mlarroque/TC-TPFF/Informe/Imagenes/etapa5.png

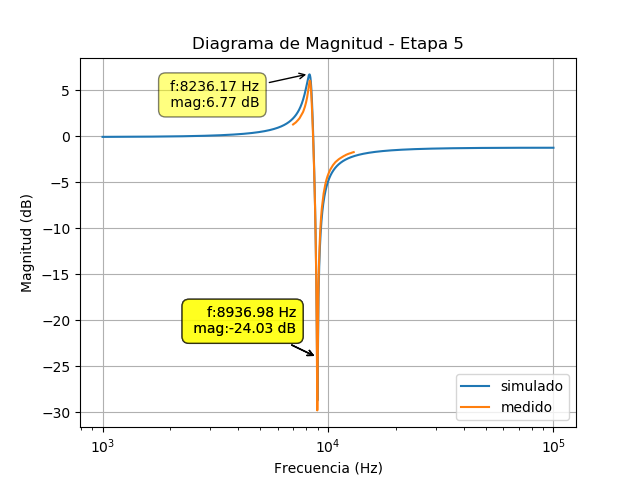
Informe/Imagenes/etapa5.png
