mlarroque/TC-TPFF/Informe/Imagenes/etapa6.png

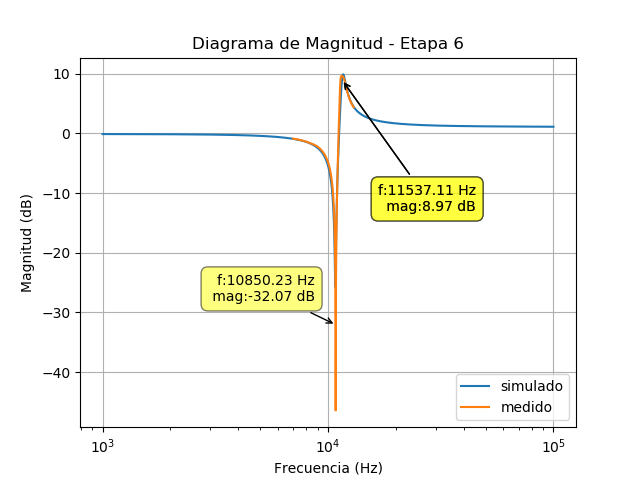
Informe/Imagenes/etapa6.png
