mlarroque/TC-TPFF/Informe/Imagenes/etapasJuntas.png

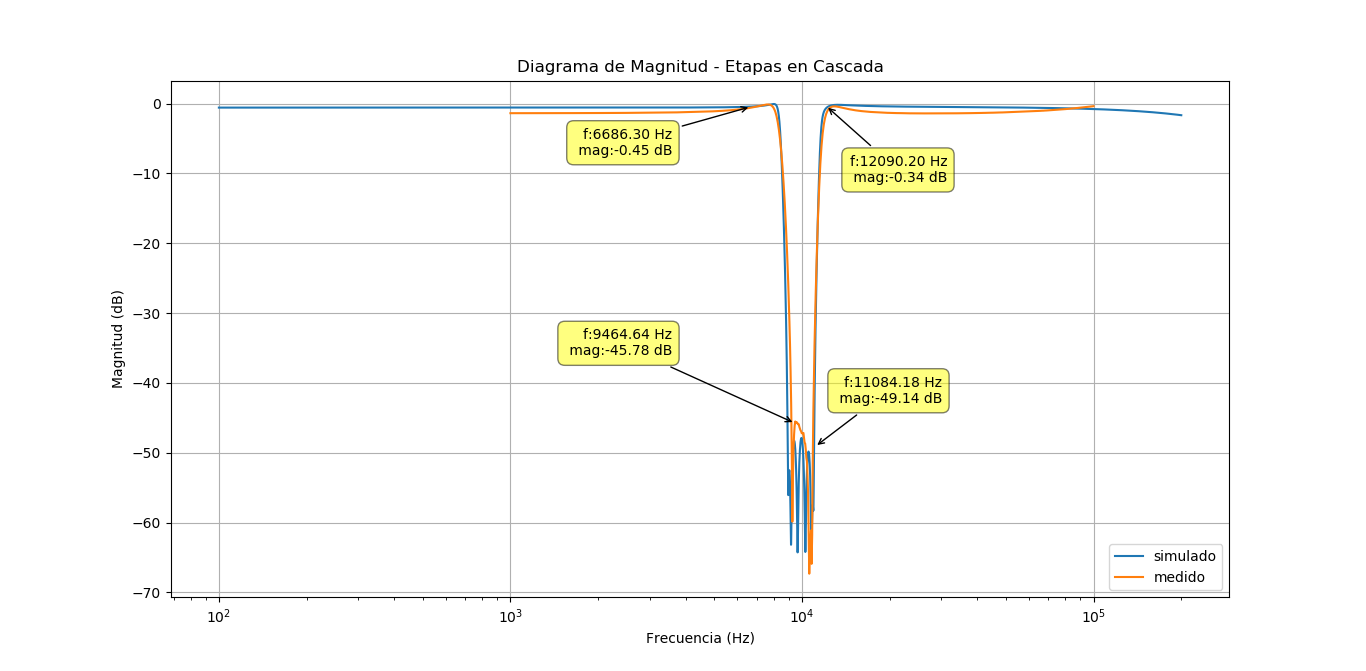
Informe/Imagenes/etapasJuntas.png
