mlarroque/TC-TPFF/Informe/Imagenes/fotoFILTRO.PNG

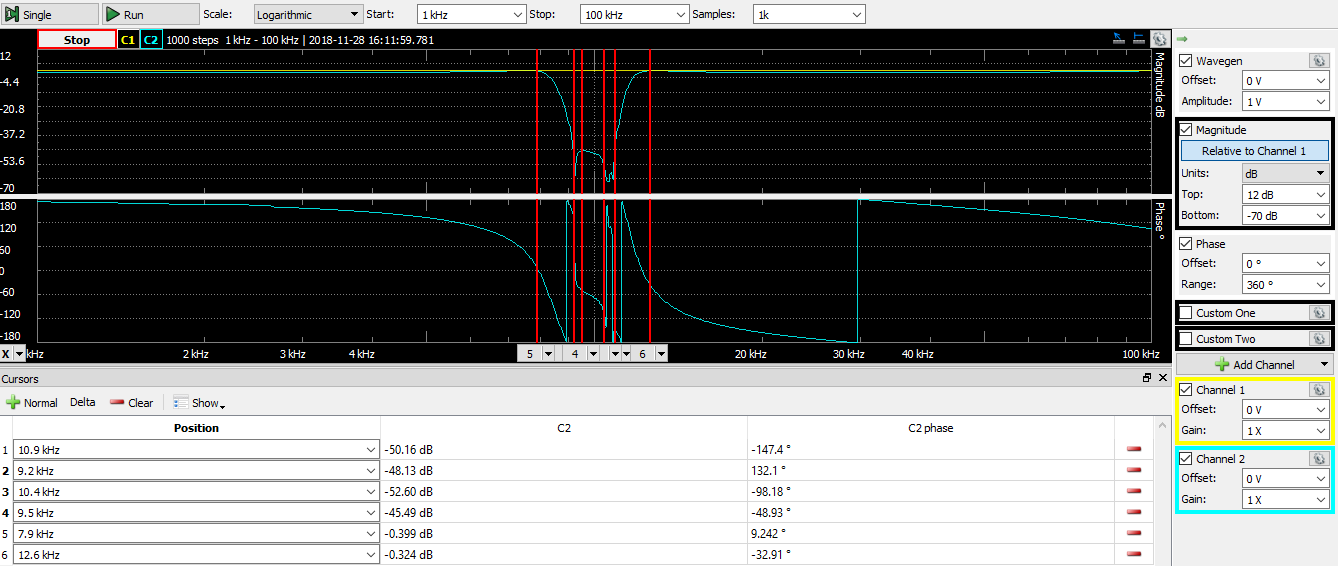
Informe/Imagenes/fotoFILTRO.PNG
