mlarroque/TC-TPFF/Informe/Imagenes/rtaESCALON.PNG

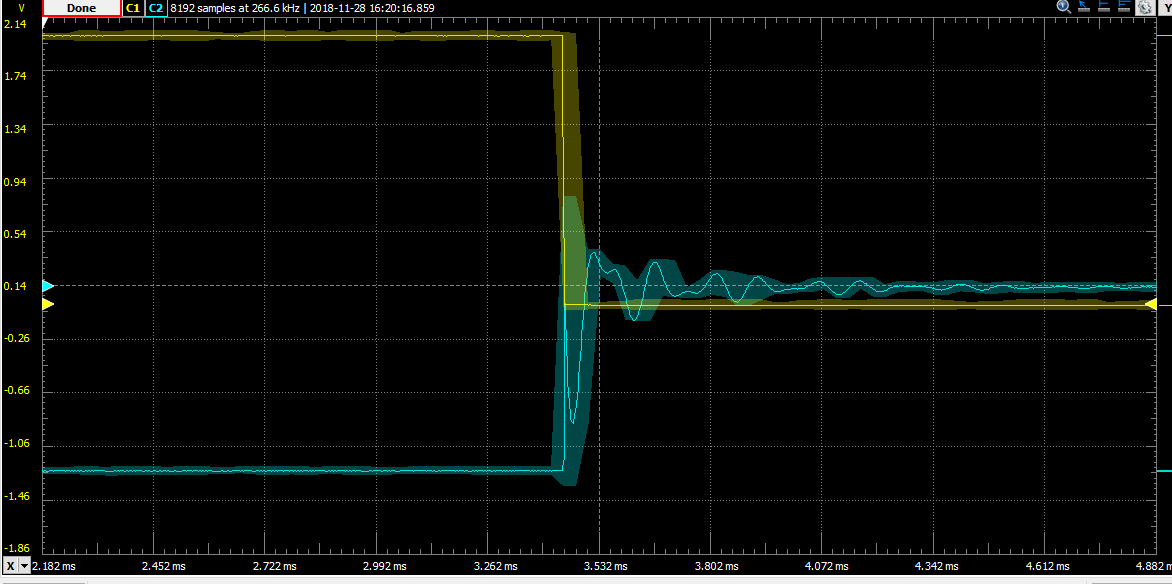
Informe/Imagenes/rtaESCALON.PNG
