mlarroque/TC-TPFF/Informe/Imagenes/SimTransfTotal.PNG

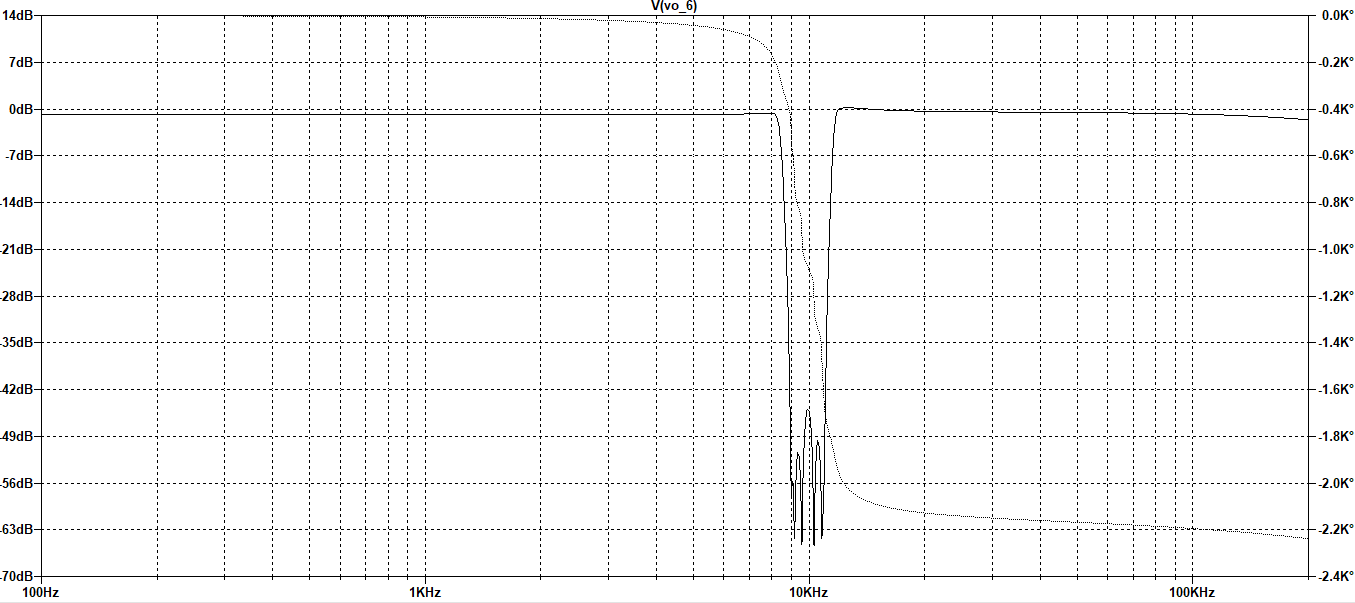
Informe/Imagenes/SimTransfTotal.PNG
