mlarroque/TC-TPFF/matlab_pablo/pablo_etapa1.PNG

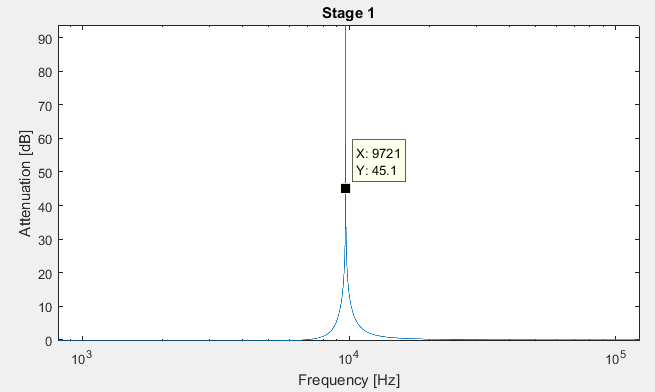
matlab_pablo/pablo_etapa1.PNG
