mlarroque/TC-TPFF/matlab_pablo/pablo_etapa2.PNG

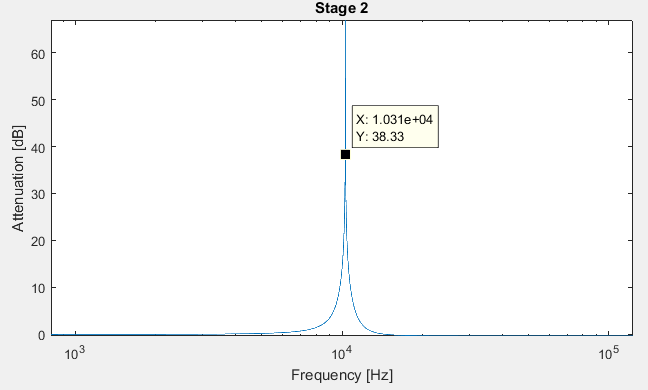
matlab_pablo/pablo_etapa2.PNG
