mlarroque/TC-TPFF/matlab_pablo/pablo_etapa3.PNG

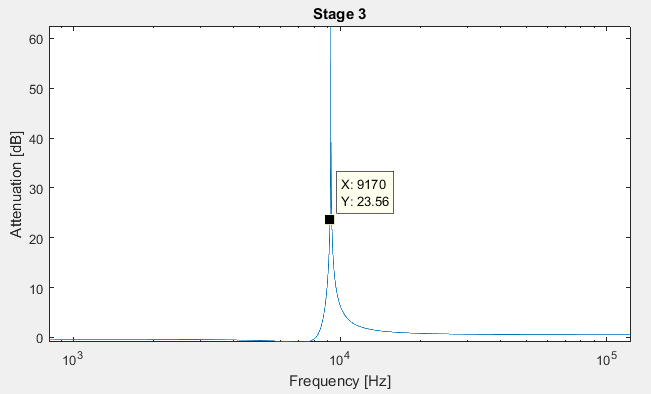
matlab_pablo/pablo_etapa3.PNG
