mlarroque/TC-TPFF/matlab_pablo/pablo_etapa5.PNG

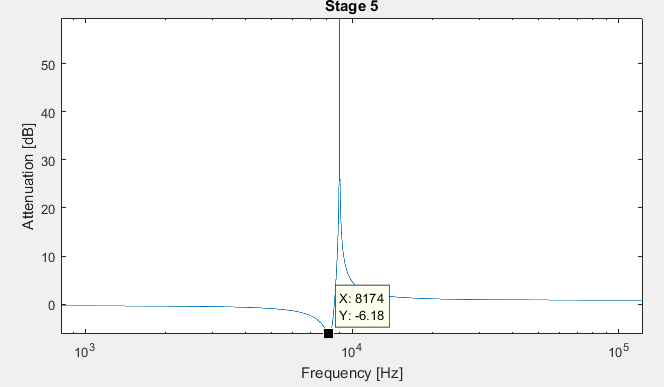
matlab_pablo/pablo_etapa5.PNG
