mlarroque/TC-TPFF/matlab_pablo/pablo_etapasJuntas.PNG

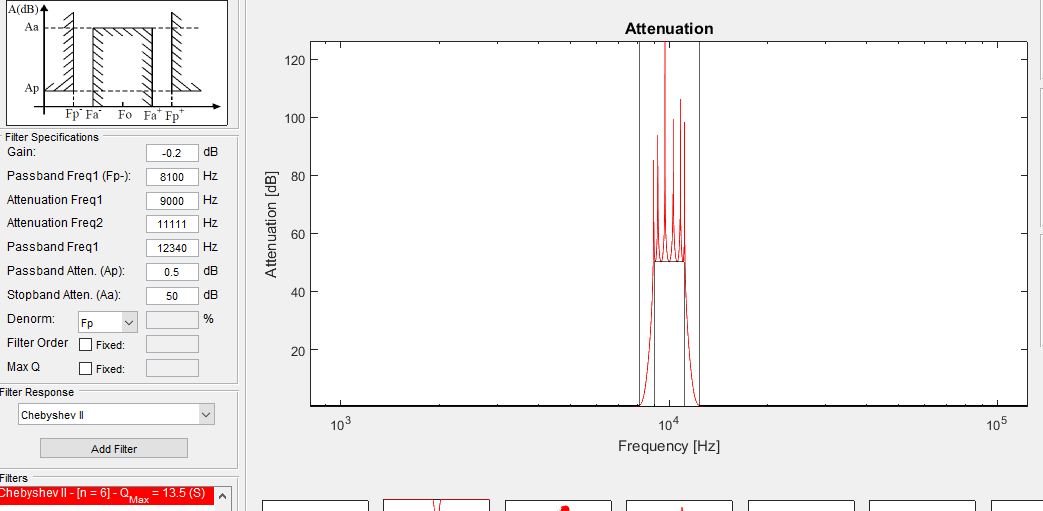
matlab_pablo/pablo_etapasJuntas.PNG
