mlarroque/TC-TPFF/matlab_pablo/publish/Filter_ImpulseResponse.png

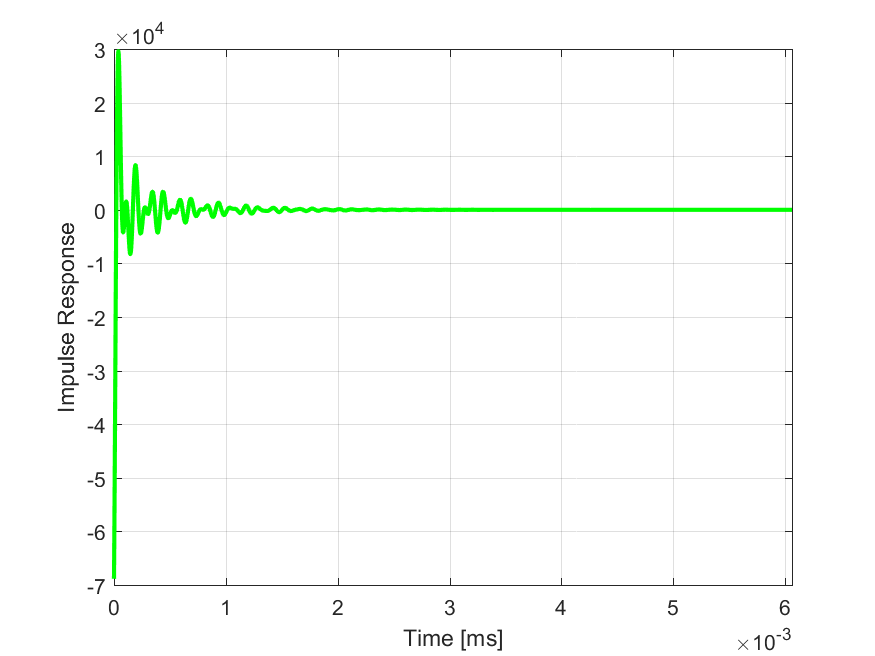
matlab_pablo/publish/Filter_ImpulseResponse.png
