mlarroque/TC-TPFF/matlab_pablo/publish/Plantillas/BandpassImg2.png

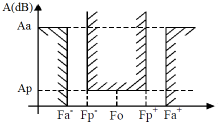
matlab_pablo/publish/Plantillas/BandpassImg2.png
