mlarroque/TC-TPFF/matlab_pablo/publish/Plantillas/HighpassImg2.png

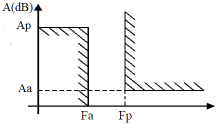
matlab_pablo/publish/Plantillas/HighpassImg2.png
