mlarroque/TC-TPFF/matlab_pablo/publish/Plantillas/LowpassImg2.png

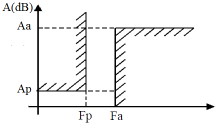
matlab_pablo/publish/Plantillas/LowpassImg2.png
