mlarroque/TC-TPFF/matlab_pablo/publish/Plantillas/StopbandImg2.png

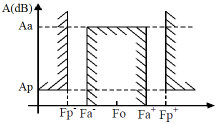
matlab_pablo/publish/Plantillas/StopbandImg2.png
