mlarroque/TC-TPFF/matlab_pablo/publish/Stages Schematics/Diff_Inv.png

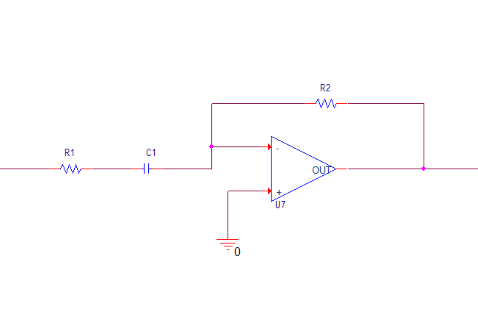
matlab_pablo/publish/Stages Schematics/Diff_Inv.png
