mlarroque/TC-TPFF/matlab_pablo/publish/Stages Schematics/Diff_No_Inv.png

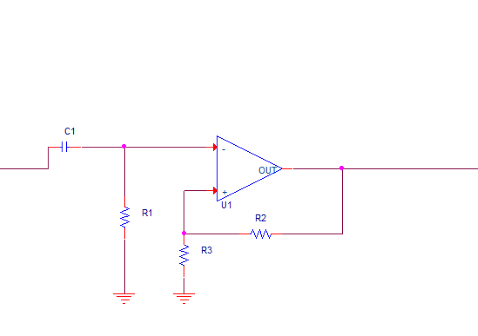
matlab_pablo/publish/Stages Schematics/Diff_No_Inv.png
