mlarroque/TC-TPFF/matlab_pablo/publish/Stages Schematics/Int_Inv.png

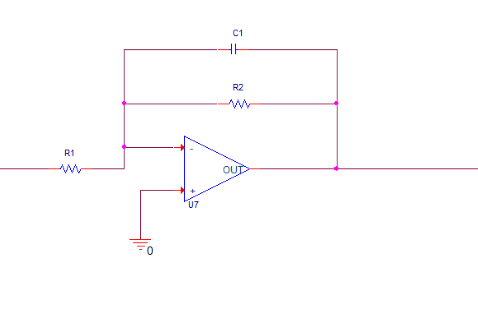
matlab_pablo/publish/Stages Schematics/Int_Inv.png
