mlarroque/TC-TPFF/matlab_pablo/publish/Stages Schematics/KHN_BP.PNG

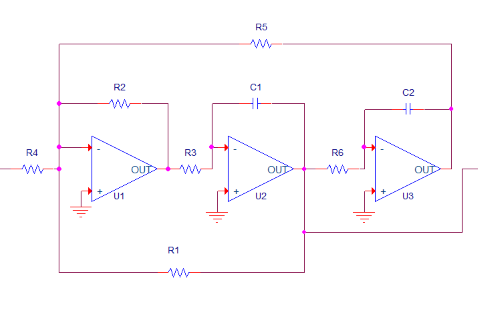
matlab_pablo/publish/Stages Schematics/KHN_BP.PNG
