mlarroque/TC-TPFF/matlab_pablo/publish/Stages Schematics/KHN_BS.PNG

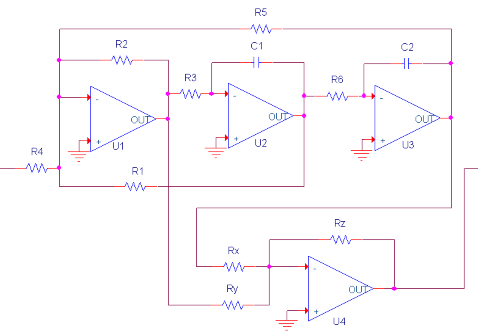
matlab_pablo/publish/Stages Schematics/KHN_BS.PNG
