mlarroque/TC-TPFF/matlab_pablo/publish/Stages Schematics/Sedra_HPNotch.png

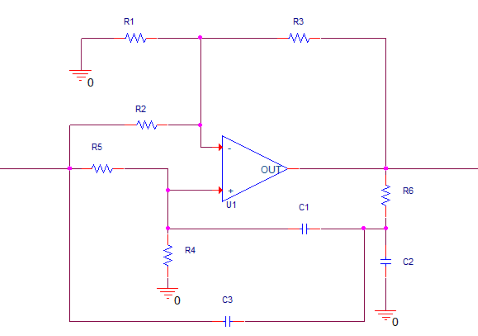
matlab_pablo/publish/Stages Schematics/Sedra_HPNotch.png
