mlarroque/TC-TPFF/matlab_pablo/publish/Stages Schematics/SK_HP.PNG

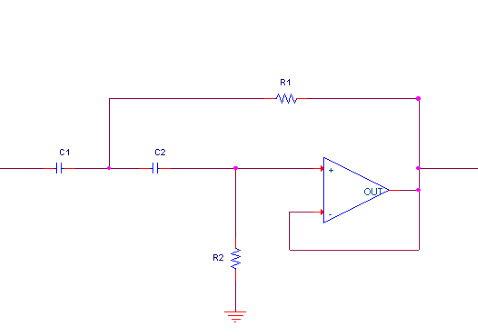
matlab_pablo/publish/Stages Schematics/SK_HP.PNG
