mlarroque/TC-TPFF/matlab_pablo/publish/Stages Schematics/SK_HP_G.PNG

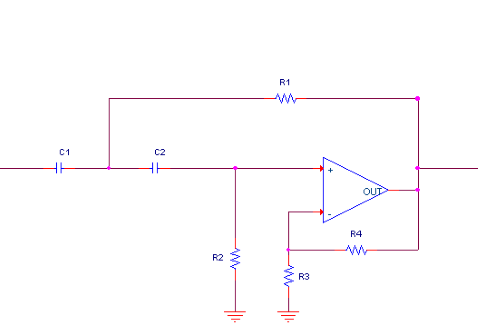
matlab_pablo/publish/Stages Schematics/SK_HP_G.PNG
