mlarroque/TC-TPFF/matlab_pablo/publish/Stages Schematics/SK_LP_A.PNG

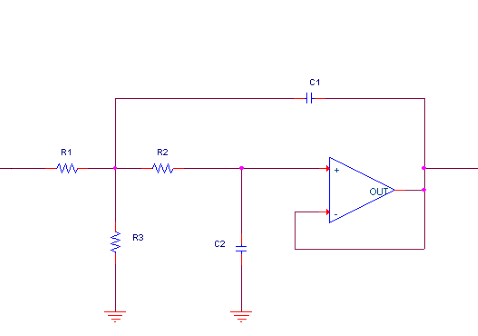
matlab_pablo/publish/Stages Schematics/SK_LP_A.PNG
