mlarroque/TC-TPFF/matlab_pablo/publish/Stages Schematics/TF.PNG

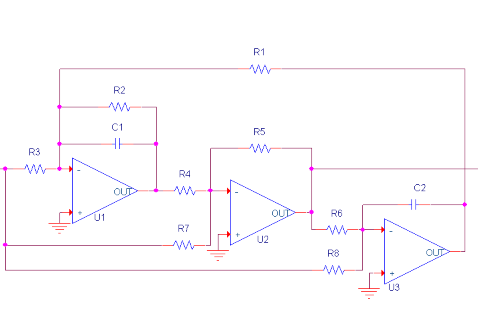
matlab_pablo/publish/Stages Schematics/TF.PNG
