mlarroque/TC-TPFF/simulaciones/montecarlo_versionFinal.PNG

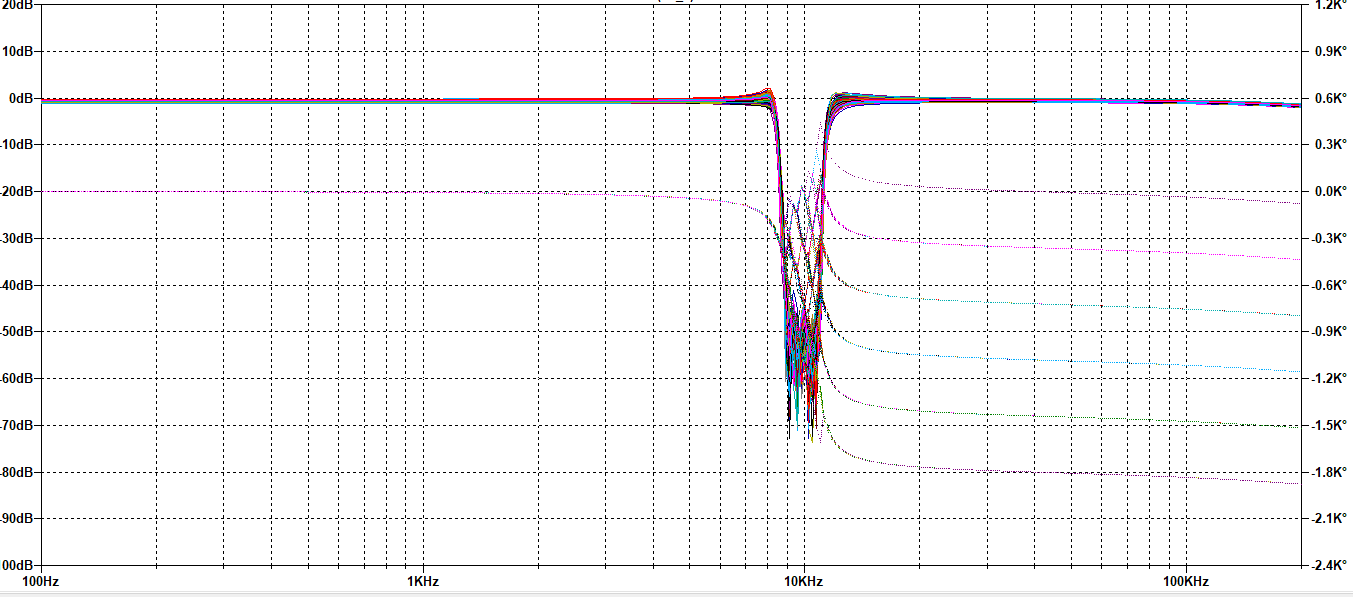
simulaciones/montecarlo_versionFinal.PNG
