mlarroque/TC-TPFF/simulaciones/montecarlo_versionFinal_algunosMatches.PNG

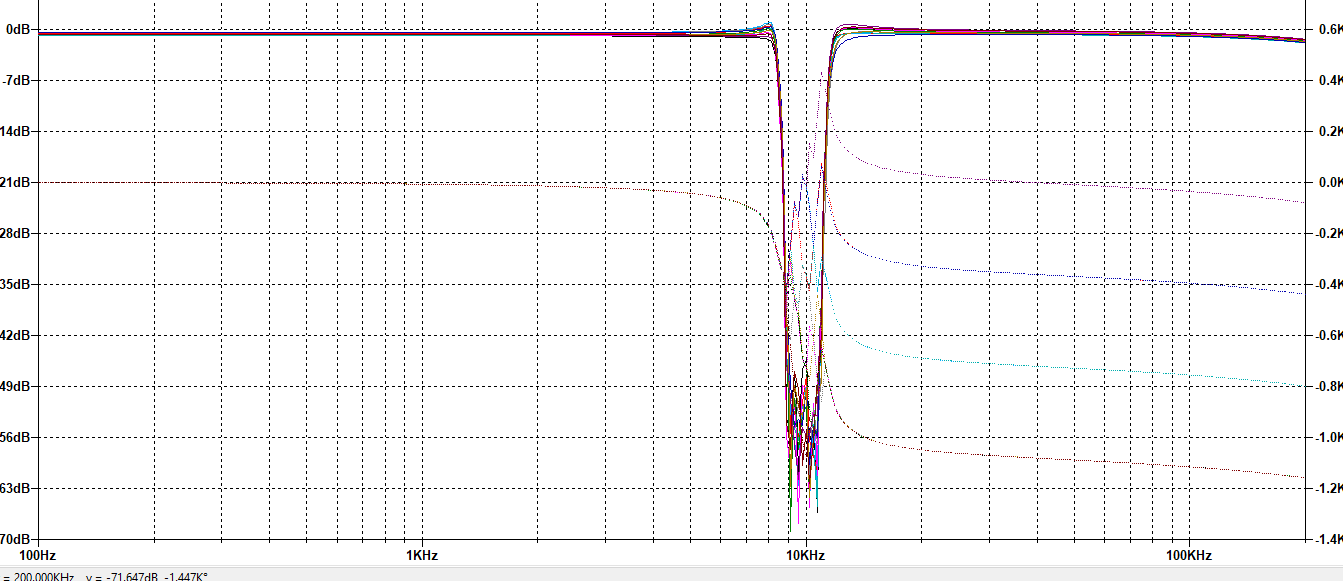
simulaciones/montecarlo_versionFinal_algunosMatches.PNG
