mlarroque/TC-TPFF/simulaciones/sim_etapasJuntasMonteCarloConMATCHES.asc

C1_1: cap; 1n
C1_2: cap; {mc(1n,tol}
C1_3: cap; 1n
C1_4: cap; 1n
C1_5: cap; 1n
C1_6: cap; 1n
C2_1: cap; 1n
C2_2: cap; {mc(1n,tol}
C2_3: cap; 1n
C2_4: cap; 1n
C2_5: cap; 1n
C2_6: cap; 1n
R1_1: res; 4500
R1_2: res; 4417
R1_3: res; 3150
R1_4: res; 3332
R1_5: res; 1227
R1_6: res; 1100
R2_1: res; 59600
R2_2: res; 54190
R2_3: res; 66k
R2_4: res; 89k
R2_5: res; 247k
R2_6: res; 190k
R3_1: res; 180k
R3_2: res; 180k
R3_3: res; 180k
R3_4: res; 180k
R3_5: res; 180k
R3_6: res; 180k
R4_1: res; 59600
R4_2: res; 54190
R4_3: res; 66k
R4_4: res; 89k
R4_5: res; 247k
R4_6: res; 190k
R5_1: res; 171k
R5_2: res; 185k
R5_3: res; 197k
R5_4: res; 161k
R5_5: res; 156k
R5_6: res; 205k
R6_1: res; 178k
R6_2: res; 178k
R6_3: res; 178k
R6_4: res; 178k
R6_5: res; 178k
R6_6: res; 178k
R7_1: res; 180k
R7_2: res; 180k
R7_3: res; 180k
R7_4: res; 180k
R7_5: res; 180k
R7_6: res; 180k
R8_1: res; 180k
R8_2: res; 180k
R8_3: res; 180k
R8_4: res; 180k
R8_5: res; 180k
R8_6: res; 180k
U1: opamp2; TL084
U2: opamp2; TL084
U3: opamp2; TL084
U4: opamp2; TL084
U5: opamp2; TL084
U6: opamp2; TL084
U7: opamp2; TL084
U8: opamp2; TL084
U9: opamp2; TL084
U10: opamp2; TL084
U11: opamp2; TL084
U12: opamp2; TL084
U13: opamp2; TL084
U14: opamp2; TL084
U15: opamp2; TL084
U16: opamp2; TL084
U17: opamp2; TL084
U18: opamp2; TL084
V1: voltage; SINE(0 1 1k 0 0 0 1000); AC 1
V2: voltage; 15
V3: voltage; 15
Named nets: +vcc, -vcc, 0, vo_1, vo_2, vo_3, vo_4, vo_5, vo_6
.inc TL084.MOD
.ac dec 2000 100 200k
.param tol=0.01
;step param run 1 10 5
;tran 10m startup
