mlarroque/TC-TPFF/simulaciones/sim_etapa4.asc

C1: cap; 1n
C2: cap; 1n
R1: res; 3.32k
R2: res; 89k
R3: res; 180k
R4: res; 89k
R5: res; 161k
R6: res; 178k
R7: res; 180k
R8: res; 180k
U1: opamp2; TL084
U2: opamp2; TL084
U3: opamp2; TL084
V1: voltage; 15
V2: voltage; 15
V3: voltage; ac 1
Named nets: 0, +vcc, -vcc, vo
.inc TL084.MOD
.ac dec 1000 1k 100k
