mlarroque/TC-TPFF/simulaciones/sim_etapasJuntasMonteCarlo.asc

C1_1: cap; {mc(1n,tol}
C1_2: cap; {mc(1n,tol}
C1_3: cap; {mc(1n,tol)}
C1_4: cap; {mc(1n,tol)}
C1_5: cap; {mc(1n,tol)}
C1_6: cap; {mc(1n,tol)}
C2_1: cap; {mc(1n,tol)}
C2_2: cap; {mc(1n,tol}
C2_3: cap; {mc(1n,tol)}
C2_4: cap; {mc(1n,tol)}
C2_5: cap; {mc(1n,tol)}
C2_6: cap; {mc(1n,tol)}
R1_1: res; {mc(4500,tol)}
R1_2: res; {mc(4417,tol)}
R1_3: res; {mc(3150,tol)}
R1_4: res; {mc(3332,tol)}
R1_5: res; {mc(1227,tol)}
R1_6: res; {mc(1100,tol)}
R2_1: res; {mc(59600,tol)}
R2_2: res; {mc(54190,tol)}
R2_3: res; {mc(66k,tol)}
R2_4: res; {mc(89k,tol)}
R2_5: res; {mc(247k,tol)}
R2_6: res; {mc(190k,tol)}
R3_1: res; {mc(180k,tol)}
R3_2: res; {mc(180k,tol)}
R3_3: res; {mc(180k,tol)}
R3_4: res; {mc(180k,tol)}
R3_5: res; {mc(180k,tol)}
R3_6: res; {mc(180k,tol)}
R4_1: res; {mc(59600,tol)}
R4_2: res; {mc(54190,tol)}
R4_3: res; {mc(66k,tol)}
R4_4: res; {mc(89k,tol)}
R4_5: res; {mc(247k,tol)}
R4_6: res; {mc(190k,tol)}
R5_1: res; {mc(171.5k,tol)}
R5_2: res; {mc(185k,tol}
R5_3: res; {mc(197k,tol)}
R5_4: res; {mc(161k,tol)}
R5_5: res; {mc(156k,tol)}
R5_6: res; {mc(205k,tol)}
R6_1: res; {mc(178k,tol)}
R6_2: res; {mc(178k,tol)}
R6_3: res; {mc(178k,tol)}
R6_4: res; {mc(178k,tol)}
R6_5: res; {mc(178.2k,tol)}
R6_6: res; {mc(178.2k,tol)}
R7_1: res; {mc(180k,tol)}
R7_2: res; {mc(180k,tol)}
R7_3: res; {mc(180k,tol)}
R7_4: res; {mc(180k,tol)}
R7_5: res; {mc(180k,tol)}
R7_6: res; {mc(180k,tol)}
R8_1: res; {mc(180k,tol)}
R8_2: res; {mc(180k,tol)}
R8_3: res; {mc(180k,tol)}
R8_4: res; {mc(180k,tol)}
R8_5: res; {mc(180k,tol)}
R8_6: res; {mc(180k,tol)}
U1: opamp2; TL084
U2: opamp2; TL084
U3: opamp2; TL084
U4: opamp2; TL084
U5: opamp2; TL084
U6: opamp2; TL084
U7: opamp2; TL084
U8: opamp2; TL084
U9: opamp2; TL084
U10: opamp2; TL084
U11: opamp2; TL084
U12: opamp2; TL084
U13: opamp2; TL084
U14: opamp2; TL084
U15: opamp2; TL084
U16: opamp2; TL084
U17: opamp2; TL084
U18: opamp2; TL084
V1: voltage; ac 1
V2: voltage; 15
V3: voltage; 15
Named nets: +vcc, -vcc, 0, vo_1, vo_2, vo_3, vo_4, vo_5, vo_6
.inc TL084.MOD
.ac dec 100 100 5Meg
.param tol=0.01
.step param run 1 10 5
