mlarroque/TC-TPFF/simulaciones/sim_etapa1_INTENTO2.asc

C1: cap; 10n
C2: cap; 10n
R1: res; 450
R2: res; 5962
R3: res; 200k
R4: res; 5962
R5: res; 448
R6: res; 465
R7: res; 200k
R8: res; 470
U1: opamp2; TL084
U2: opamp2; TL084
U3: opamp2; TL084
V1: voltage; 15
V2: voltage; 15
V3: voltage; ac 1
Named nets: 0, +vcc, -vcc, vo
.inc TL084.MOD
.ac dec 500 100 5Meg
