mlarroque/TC-TPFF/simulaciones/Estabilidad/sim_etapa3.asc

C1: cap; 1n
C2: cap; 1n
R1: res; 3148
R2: res; 69k
R3: res; 180k
R4: res; 69k
R5: res; 197.2k
R6: res; 178.2k
R7: res; 180k
R8: res; 180k
U1: opamp2; TL084
U2: opamp2; TL084
U3: opamp2; TL084
V1: voltage; 15
V2: voltage; 15
V3: voltage; ""; AC 1 0
Named nets: 0, +vcc, -vcc, vo, feedb, inv
.inc TL084.MOD
.ac dec 2000 100m 1Meg
