mlarroque/TC-TPFF/(list of files, drawings)

Other design files:
altium/archivosUsadosParaRuteo/altium_final.PrjPcb
altium/archivosUsadosParaRuteo/filtroFinal.PcbDoc
altium/etapa1.SchDoc
altium/etapa2.SchDoc
altium/etapa3.SchDoc
altium/etapa4.SchDoc
altium/etapa5.SchDoc
altium/etapa6.SchDoc
altium/filtroFinal-TC.SchDoc
altium/filtroFinal.PrjPCB
