mlarroque/TC-TPFF/(commit log)

2018-11-19 avances con los calculos de componentes y simulacion
2018-11-19 subo el informe del tp5 tomado de referencia
2018-11-24 se sube publish de pablo, y montecarlos en spice
2018-11-25 actualize el "paper"
2018-11-25 Hice una parte para simulaciones de estabilidad
2018-11-25 Hice las simulaciones de estabilidad
    [sim_etapa1.csv]
2018-11-25 Empezando los graficos de estabilidad
    [sim_etapa1.csv, sim_etapa1.xls, sim_etapa2.csv, sim_etapa3.csv, sim_etapa4.csv, sim_etapa5.csv, sim_etapa6.csv]
2018-11-25 se guardaron simulaciones de plantilla
    [etapa1.SchDoc, etapa2.SchDoc, etapa5.SchDoc]
2018-11-25 se termina la placa
    [etapa1.SchDoc, etapa2.SchDoc, etapa3.SchDoc, etapa4.SchDoc, etapa5.SchDoc, etapa6.SchDoc, filtroFinal-TC.SchDoc]
2018-11-25 Simule estabilidad
    [sim_etapa1.xls, sim_etapa2.csv, sim_etapa3.csv, sim_etapa4.csv, sim_etapa5.csv, sim_etapa6.csv]
2018-11-26 subo el ruteo de la placa
    [altium_final.PrjPcb, filtroFinal.PcbDoc]
2018-11-28 Progreso en el informe
    [bodeFinalCasiCasi.csv, bodeFinalLargo.csv, bodeFinalPOSTAPOSTA.csv, bodeFinalcorto.csv, etapa1.SchDoc, filtroFinal-TC.SchDoc, rtaESCA.csv]
2018-11-28 csv etapas
    [etapa1.csv, etapa2.csv, etapa3.csv, etapa4.csv, etapa5.csv, etapa6.csv]
2018-11-28 avance con los graficos
    [med_total.csv, sim_etapa1.csv, sim_etapa2.csv, sim_etapa3.csv, sim_etapa4.csv, sim_etapa5.csv, sim_etapa6.csv, sim_total.csv]
2018-11-28 se agregan imagenes
    [med_etapa1.csv, med_etapa2.csv, med_etapa3.csv, med_etapa4.csv, med_etapa5.csv, med_etapa6.csv, sim_total.csv]
2018-11-29 version de entrega
